abdul-basit-shaikh/CH32V003F4P6_tank_sensor/Tank_Sensor_Hardware_List.xlsx

Sheet: BOM_Components_List
CH32V003F4P6 TANK WATER LEVEL SENSOR — COMPLETE BOM & ROBU.IN BUYING LIST
S.No | Ref | Component Name | Value / Specification | Package / Footprint | Qty | Purpose & Function (Kis Liye Lagta Hai) | Robu.in Link | Buying / Engineering Notes
1 | U1 | Main Microcontroller (MCU) | CH32V003F4P6 (RISC-V 32-bit, 48MHz, 16KB Flash, 2KB SRAM) | TSSOP-20 | 1 | Poore tank sensor ka main brain. Probes read karta hai, deep sleep manage karta hai, battery calculate karta hai, aur LoRa se controller ko data bhejta hai. | 🔗 View on Robu.in (https://robu.in/?s=CH32V003&post_type=product) | Ultra-low power (~10µA sleep). WCH RISC-V core.
2 | U2 | Wireless LoRa Module | SX1278 Ra-02 (Ai-Thinker 433MHz) | SMD-16 Module | 1 | 433MHz Long Range Radio. Tanki se controller tak 500m - 1km+ range me water level aur battery data wirelessly transmit karta hai. | 🔗 View on Robu.in (https://robu.in/?s=SX1278+LoRa+Module+Ra-02&post_type=product) | SPI Interface, 433MHz frequency band.
3 | Q6 | P-Channel MOSFET | AO3401A / SI2301 (30V, 4.2A, Low Rds(on)) | SOT-23 | 1 | Anti-Corrosion High-Side Switch. Paani ke common wire me 24/7 current nahi bhejta. Jab MCU reading leta hai sirf 10ms ke liye VCC pulse deta hai, baki waqt paani me 0V rehta hai taaki probes rust/electrolysis se kharab na hon. | 🔗 View on Robu.in (https://robu.in/?s=AO3401A+MOSFET&post_type=product) | Gate connected to PD3 via 100k pull-up.
4 | Q1 | NPN Transistor (25% Probe) | BC547 / 2N3904 / MMBT3904 | TO-92 / SOT-23 | 1 | 25% Water Level Buffer. Paani 25% probe ko touch karta hai toh base trigger hokar Collector (PC0) ko LOW (0V) pull karta hai. | 🔗 View on Robu.in (https://robu.in/?s=BC547+Transistor&post_type=product) | Emitter to GND, Base via 100k resistor.
5 | Q2 | NPN Transistor (50% Probe) | BC547 / 2N3904 / MMBT3904 | TO-92 / SOT-23 | 1 | 50% Water Level Buffer. 50% level touch hone par Collector (PC1) ko LOW pull karta hai. | 🔗 View on Robu.in (https://robu.in/?s=BC547+Transistor&post_type=product) | Emitter to GND, Base via 100k resistor.
6 | Q3 | NPN Transistor (75% Probe) | BC547 / 2N3904 / MMBT3904 | TO-92 / SOT-23 | 1 | 75% Water Level Buffer. 75% level touch hone par Collector (PC2) ko LOW pull karta hai. | 🔗 View on Robu.in (https://robu.in/?s=BC547+Transistor&post_type=product) | Emitter to GND, Base via 100k resistor.
7 | Q4 | NPN Transistor (100% Probe) | BC547 / 2N3904 / MMBT3904 | TO-92 / SOT-23 | 1 | 100% Water Level Buffer. 100% level touch hone par Collector (PC4) ko LOW pull karta hai. | 🔗 View on Robu.in (https://robu.in/?s=BC547+Transistor&post_type=product) | Emitter to GND, Base via 100k resistor.
8 | Q5 | P-Channel MOSFET (Option B) | AO3401A / SI2301 | SOT-23 | 1 (Opt B) | Zero-Drop Reverse Battery Protection. 2x AA direct mode me battery ulti lagne par circuit ko instantly disconnect karta hai (Sirf 0.004V drop). | 🔗 View on Robu.in (https://robu.in/?s=AO3401A+MOSFET&post_type=product) | Gate to GND, Source to Bat+, Drain to Switch.
9 | U3 | 3.3V Low-Iq LDO (Option A) | HT7333-2 (Holtek) / XC6206P332MR | SOT-89 / SOT-23 | 1 (Opt A) | Voltage Regulator. 4x AA (6V) battery setup me voltage ko solid 3.3V pe regulate karta hai (Quiescent current < 3µA). | 🔗 View on Robu.in (https://robu.in/?s=HT7333&post_type=product) | High efficiency LDO for 5-7 years battery life.
10 | D2 | Step-down & Reverse Diode (Option A) | 1N4007 / M7 / 1N4002 | DO-41 / SMA | 1 (Opt A) | LDO Overvoltage Protection. 4x AA naye cells (6.4V) ko 0.7V drop karke 5.7V safe banata hai aur reverse polarity rokta hai. | 🔗 View on Robu.in (https://robu.in/?s=1N4007+Diode&post_type=product) | 1A general purpose rectifier.
11 | F1 | Resettable PTC Fuse | 500mA Resettable Fuse (Bourns / Littelfuse) | 1206 SMD | 1 | Short Circuit Protection. Agar battery terminals ya board me short circuit ho toh battery ko blast ya drain hone se bachata hai. | 🔗 View on Robu.in (https://robu.in/?s=1206+PTC+Fuse+500mA&post_type=product) | Auto-reset when short is cleared.
12 | C1 | Main Bulk Reservoir Capacitor | 100µF 16V / 25V (Electrolytic / Ceramic) | Radial / 1206 | 1 | Energy Reservoir. Battery ke paas lagta hai. Jab LoRa module TX ke waqt sudden 120mA current spike leta hai, ye voltage drop nahi hone deta. | 🔗 View on Robu.in (https://robu.in/?s=100uF+Capacitor&post_type=product) | Essential for battery longevity & radio stability.
13 | C2 | LoRa Bulk Capacitor | 10µF 10V/16V Ceramic | 0805 SMD | 1 | LoRa Local Power Buffer. LoRa VCC/GND ke 3mm paas lagta hai for local current supply. | 🔗 View on Robu.in (https://robu.in/?s=10uF+0805+SMD+Capacitor&post_type=product) | Low ESR Ceramic capacitor.
14 | C3 | LoRa RF Decoupling Capacitor | 100nF (104) 50V Ceramic | 0603 / 0805 SMD | 1 | High-Frequency Noise Filter. LoRa module ke digital switching aur SPI clock noise ko ground karta hai. | 🔗 View on Robu.in (https://robu.in/?s=100nF+0805+SMD+Capacitor&post_type=product) | Place right at LoRa VCC/GND pins.
15 | C4 | MCU Decoupling Capacitor | 100nF (104) 50V Ceramic | 0603 / 0805 SMD | 1 | MCU Power Filter. CH32V003 MCU ke VDD (Pin 9) aur VSS (Pin 7) ke bilkul paas lagta hai. | 🔗 View on Robu.in (https://robu.in/?s=100nF+0805+SMD+Capacitor&post_type=product) | Clean digital supply for MCU.
16 | C5 | MCU Reset Capacitor | 100nF (104) 50V Ceramic | 0603 / 0805 SMD | 1 | Clean Power-On Reset. NRST pin ko power-on par clean reset pulse deta hai aur false resets rokta hai. | 🔗 View on Robu.in (https://robu.in/?s=100nF+0805+SMD+Capacitor&post_type=product) | Connected from NRST to GND.
17 | C6-C9 | Probe Filter Capacitors | 4x 100nF (104) 50V Ceramic | 0603 / 0805 SMD | 4 | Noise / ESD Filter. Tanki ke 25%, 50%, 75%, 100% lambe taaron se aane wale static, RF noise aur false triggering ko ground karte hain. | 🔗 View on Robu.in (https://robu.in/?s=100nF+0805+SMD+Capacitor&post_type=product) | Connected across each probe input to GND.
18 | C10 | Common Line Filter Capacitor | 100nF (104) 50V Ceramic | 0603 / 0805 SMD | 1 | Common Line Protection. Common sensor line ko ESD aur static spike se bachata hai. | 🔗 View on Robu.in (https://robu.in/?s=100nF+0805+SMD+Capacitor&post_type=product) | Connected from Common to GND.
19 | R3 | NRST Pull-up Resistor | 10kΩ 5% (0.125W) | 0603 / 0805 SMD | 1 | Reset Pin Stabilizer. CH32V003 ke NRST (Pin 4) ko VCC se pull-up rakhta hai taaki chip hang na ho. | 🔗 View on Robu.in (https://robu.in/?s=10k+0805+SMD+Resistor&post_type=product) | NRST to VDD.
20 | R4 | LED Resistor | 1kΩ 5% (0.125W) | 0603 / 0805 SMD | 1 | LED Current Limiter. Status LED (PD2) ko safe 1-2mA current deta hai taaki battery waste na ho. | 🔗 View on Robu.in (https://robu.in/?s=1k+0805+SMD+Resistor&post_type=product) | PD2 to LED Anode.
21 | R5-R8 | Probe Base Resistors | 4x 100kΩ 5% (0.125W) | 0603 / 0805 SMD | 4 | Transistor Base Current Limiter. Q1-Q4 BC547 ke base me safe micro-ampere current allow karte hain jab paani touch hota hai. | 🔗 View on Robu.in (https://robu.in/?s=100k+0805+SMD+Resistor&post_type=product) | Probe lines to Base pins.
22 | R9 | MOSFET Gate Pull-up Resistor | 100kΩ 5% (0.125W) | 0603 / 0805 SMD | 1 | Q6 Gate Lock. PD3 floating hone par ya deep sleep ke waqt Q6 Gate ko VCC se pull karke MOSFET ko 100% OFF rakhta hai. | 🔗 View on Robu.in (https://robu.in/?s=100k+0805+SMD+Resistor&post_type=product) | Q6 Gate to VCC.
23 | D1 | Status Indicator LED | 3mm Green LED / 0805 SMD | SMD / TH | 1 | User Feedback. Pairing mode, reset indication, aur data transmission confirmation blink karne ke liye. | 🔗 View on Robu.in (https://robu.in/?s=Green+LED+0805&post_type=product) | Active HIGH from PD2.
24 | SW1 | User Push Button | 6x6mm Tactile Switch | SMD / TH | 1 | Pairing & Reset. 3s hold = Reboot, 5s hold = Controller ke saath Pairing Mode. | 🔗 View on Robu.in (https://robu.in/?s=Tactile+Push+Button+6x6&post_type=product) | Active LOW connected to PD6.
25 | SW2 | Power Slide Switch | SPST Slide Switch 3-Pin | Through-Hole | 1 | Battery ON/OFF Switch. Board ko storage ya maintenance ke waqt physically switch off karne ke liye. | 🔗 View on Robu.in (https://robu.in/?s=SPST+Slide+Switch&post_type=product) | In series with battery positive line.
26 | J1 | Battery Connector | 2-Pin JST-XH / 2.54mm Screw Terminal | Through-Hole | 1 | Battery pack (2x AA ya 4x AA holder) connect karne ke liye. | 🔗 View on Robu.in (https://robu.in/?s=JST+XH+2+Pin+Connector&post_type=product) | Polarized connector recommended.
27 | J2 | SWD Programming Header | 1x3 Male Header (2.54mm) | Through-Hole | 1 | Firmware Flashing. WCH-LinkE programmer se code upload karne ke liye (VCC, SWIO/PD1, GND). | 🔗 View on Robu.in (https://robu.in/?s=2.54mm+Male+Berg+Strip&post_type=product) | Single-wire debug header.
28 | J3 | Tank Sensor Connector | 1x5 Screw Terminal Block (3.81mm / 5.08mm) | Through-Hole | 1 | Tanki ke 5 taar connect karne ke liye: Common (VCC), 25%, 50%, 75%, 100%. | 🔗 View on Robu.in (https://robu.in/?s=5+Pin+Screw+Terminal+Block&post_type=product) | Heavy duty screw terminal.
29 | J4 | Debug UART Header | 1x2 Male Header (2.54mm) | Through-Hole | 1 | Serial monitor debugging ke liye (PD5 TX + GND). | 🔗 View on Robu.in (https://robu.in/?s=2.54mm+Male+Berg+Strip&post_type=product) | Optional for debugging.
30 | ANT1 | 433MHz LoRa Antenna | Spring Coil Antenna / IPEX SMA Whip | 433 MHz | 1 | LoRa signal transmit karne ke liye. | 🔗 View on Robu.in (https://robu.in/?s=433MHz+Spring+Antenna&post_type=product) | Solder directly or use IPEX connector.
31 | PROBES | Water Level Probes | SS304 / SS316 Stainless Steel Screws / Rods | M3 / M4 Bolt | 5 | Paani ke andar daalne ke liye rust-proof probes. | 🔗 View on Robu.in (https://robu.in/?s=Stainless+Steel+Bolt+M3&post_type=product) | Stainless steel (Do not use bare copper).
32 | PROG1 | WCH Programmer (Tool) | WCH-LinkE Programmer / Debugger | USB Tool | 1 | CH32V003 MCU me code flash aur debug karne ke liye official hardware programmer. | 🔗 View on Robu.in (https://robu.in/?s=WCH-LinkE+Programmer&post_type=product) | Connects to J2 header (SWIO, VCC, GND).

Sheet: MCU_Pin_Mapping
CH32V003F4P6 TSSOP-20 COMPLETE PIN MAPPING
TSSOP-20 Pin | Pin Name | Connected Component / Signal | Direction / Mode | Description & Circuit Function
Pin 1 | PD4 | SX1278 LoRa RST | Output | LoRa Module Hardware Reset Line
Pin 2 | PD5 | J4 Debug UART TX | Output | 115200 Baud Serial Debug Print (Optional)
Pin 3 | PD6 | SW1 Push Button | Input (Pull-Up) | Pairing / Reset / Reboot Button (Active LOW, EXTI Wakeup)
Pin 4 | PD7 | NRST (R3 10k + C5 104) | Input / Reset | MCU Hardware Reset with RC Noise Filter
Pin 5 | PA1 | NC (Internal Vref used) | Analog Input | Battery monitored via 1.20V Internal Bandgap (0µA drain)
Pin 6 | PA2 | NC | Spare GPIO | Unconnected / Spare Test Pad
Pin 7 | VSS | Ground Plane (GND) | Power | Main System Ground
Pin 8 | PD0 | NC | Spare GPIO | Unconnected / Spare Test Pad
Pin 9 | VDD | VCC Rail (3.0V - 3.3V) + C4 (104) | Power | Main MCU Power Input (with 100nF Decoupling Cap)
Pin 10 | PC0 | Q1 Collector (25% Probe) | Input (Pull-Up) | 25% Water Level Detector (Reads LOW when water reaches 25%)
Pin 11 | PC1 | Q2 Collector (50% Probe) | Input (Pull-Up) | 50% Water Level Detector (Reads LOW when water reaches 50%)
Pin 12 | PC2 | Q3 Collector (75% Probe) | Input (Pull-Up) | 75% Water Level Detector (Reads LOW when water reaches 75%)
Pin 13 | PC3 | SX1278 LoRa NSS (CS) | Output | SPI Chip Select for SX1278 LoRa Module
Pin 14 | PC4 | Q4 Collector (100% Probe) | Input (Pull-Up) | 100% Water Level Detector (Reads LOW when water reaches 100%)
Pin 15 | PC5 | SX1278 LoRa SCK | AF Output | SPI1 Clock Line for LoRa Communication
Pin 16 | PC6 | SX1278 LoRa MOSI | AF Output | SPI1 Master-Out-Slave-In Data Line
Pin 17 | PC7 | SX1278 LoRa MISO | Input (Pull-Up) | SPI1 Master-In-Slave-Out Data Line
Pin 18 | PD1 | J2 SWIO Header | Bidirectional | Single-Wire Debug / Flash Programming Interface
Pin 19 | PD2 | D1 Status LED (via R4 1k) | Output | Status Indicator LED (Active HIGH: Blinks for TX, Pairing)
Pin 20 | PD3 | Q6 P-MOSFET Gate (via R9 100k) | Output | Common Probe Driver (Active LOW: Pulsed 3V for 10ms)
