abdul-basit-shaikh/CH32V003F4P6_tank_sensor/(list of files, drawings)

Other design files:
PCB/temp-freerouting.dsn
