abdul-basit-shaikh/CH32V003F4P6_tank_sensor/PCB/Tank_Sensor.kicad_pcb

## KiCad design PCB/Tank_Sensor.kicad_pcb (2026-08-27)

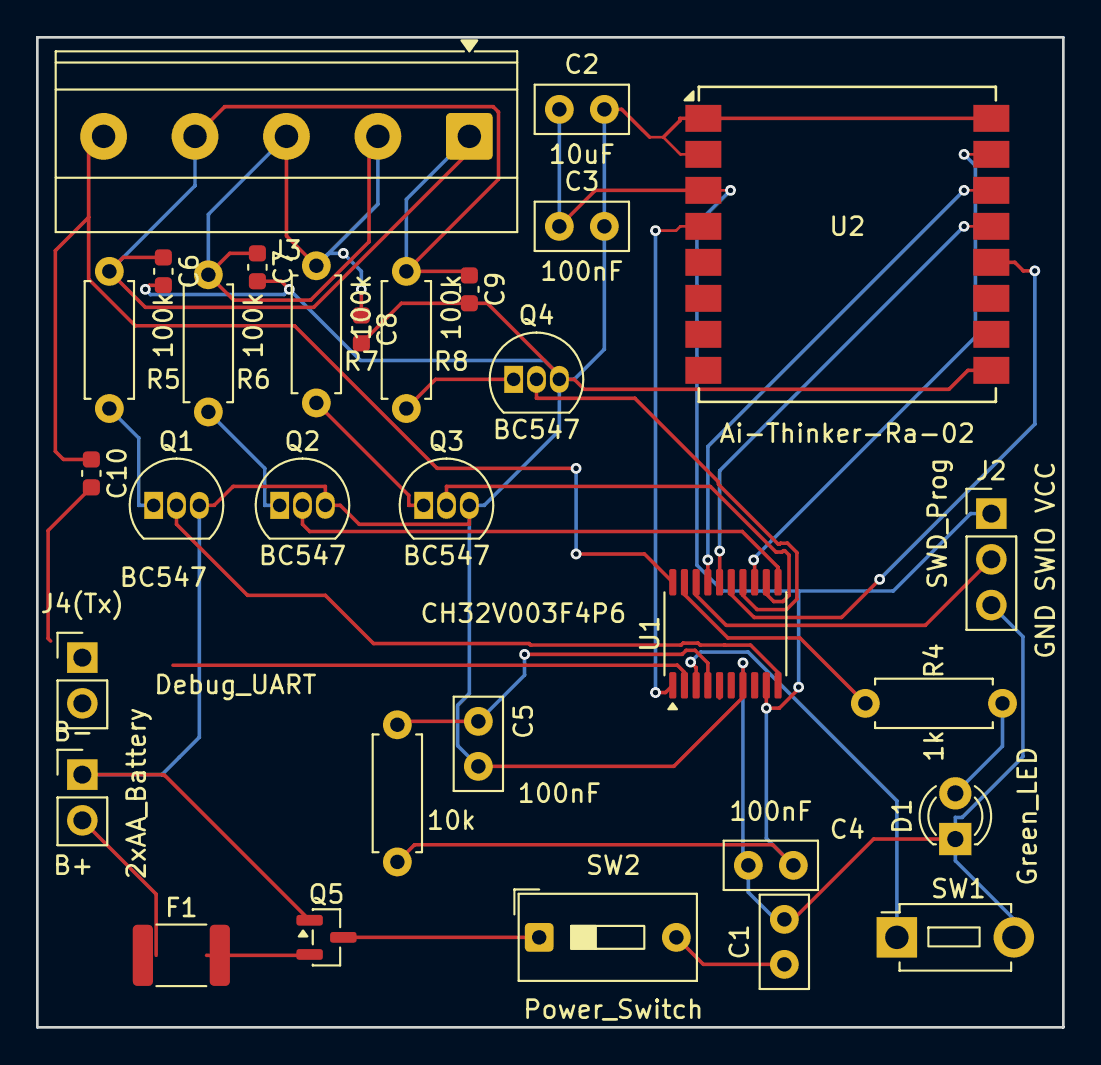
[picture p1: board Tank_Sensor.kicad_pcb from above]

Board: 2 copper layers, 57.0 x 55.0 mm, 31 parts (0 on the bottom side), 27 nets.

Parts:
B-: 2xAA_Battery; PinHeader_1x02_P2.54mm_Vertical
C1: 100uF; C_Disc_D5.0mm_W2.5mm_P2.50mm
C2: 10uF; C_Disc_D5.0mm_W2.5mm_P2.50mm
C3, C4, C5: 100nF; C_Disc_D5.0mm_W2.5mm_P2.50mm
C6, C7, C8, C9, C10: 100nF; C_0603_1608Metric
D1: Green_LED; LED_D3.0mm
F1: 500mA_PTC; Fuse_1812_4532Metric
J2: SWD_Prog; PinHeader_1x03_P2.54mm_Vertical
J3: Sensor_Conn; TerminalBlock_Phoenix_MKDS-1,5-5-5.08_1x05_P5.08mm_Horizont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
J4(Tx): Debug_UART; PinHeader_1x02_P2.54mm_Vertical
Q1, Q2, Q3, Q4: BC547; TO-92_Inline
Q5: AO3401A; SOT-23
R3: 10k; R_Axial_DIN0207_L6.3mm_D2.5mm_P7.62mm_Horizontal
R4: 1k; R_Axial_DIN0207_L6.3mm_D2.5mm_P7.62mm_Horizontal
R5, R6, R7, R8: 100k; R_Axial_DIN0207_L6.3mm_D2.5mm_P7.62mm_Horizontal
SW1: BTN_6mm; SW_PUSH_1P1T_6x3.5mm_H5.0_APEM_MJTP1250
SW2: Power_Switch; SW_DIP_SPSTx01_Slide_9.78x4.72mm_W7.62mm_P2.54mm
U1: CH32V003F4P6; TSSOP-20_4.4x6.5mm_P0.65mm
U2: Ai-Thinker-Ra-02; Ai-Thinker-Ra-01-LoRa

Connections:
/BTN: SW1.1, U1.3 (PD6)
/LED_A: D1.2 (A), R4.2
/LED_DRIVE: R4.1, U1.19 (PD2)
/LORA_NSS: U1.13 (PC3/NSS), U2.15 (~NSS)
/LORA_RST: U1.1 (PD4), U2.4 (~RESET)
/NRST: C5.1, R3.2, U1.4 (~NRST/PD7)
/PROBE_25: C6.1, J3.1, R5.1
/PROBE_50: C7.1, J3.2, R6.1
/PROBE_75: C8.1, J3.3, R7.1
/PROBE_100: C9.1, J3.4, R8.1
/Q1_B: Q1.1 (B), R5.2
/Q2_B: Q2.1 (B), R6.2
/Q3_B: Q3.1 (B), R7.2
/Q4_B: Q4.1 (B), R8.2
/SENSOR_25: Q1.2 (C), U1.10 (PC0)
/SENSOR_50: Q2.2 (C), U1.11 (PC1)
/SENSOR_75: Q3.2 (C), U1.12 (PC2)
/SENSOR_100: Q4.2 (C), U1.14 (PC4)
/SPI_MISO: U1.17 (PC7/MISO), U2.14 (MOSI)
/SPI_MOSI: U1.16 (PC6/MOSI), U2.13 (MISO)
/SPI_SCK: U1.15 (PC5/SCK), U2.12 (SCK)
/SWIO: J2.2, U1.18 (PD1/SWIO)
/UART_TX: J4(Tx).1, U1.2 (PD5/UTX)
GND: B-.1, C1.2, C2.2, C3.2, C4.2, C5.2, C6.2, C7.2, C8.2, C9.2, C10.2, D1.1 (K), J2.3, J4(Tx).2, Q1.3 (E), Q2.3 (E), Q3.3 (E), Q4.3 (E), Q5.1 (G), SW1.2, U1.7 (VSS), U2.1 (GND), U2.2 (GND), U2.9 (GND), U2.16 (GND)
unnamed: Q5.3 (D), SW2.1
unnamed: F1.2, Q5.2 (S)
VCC: C1.1, C2.1, C3.1, C4.1, J2.1, R3.1, SW2.2, U1.9 (VDD), U1.20 (PD3), U2.3 (VDD)
