abdul-basit-shaikh/CH32V003F4P6_tank_sensor/(commit log)

2026-01-26 tank level ky liye pin or button or led ky pin set kr diya hai or data abhi ja raha hai or recveed bhi ho raha hai water level controller pr sahi se
2026-02-07 jab reset button pressed kary gy to tank id change hogi
2026-02-21 sanser first time add ho raha tha sirf os ko fixed kiya hai abhi kitne bar bhi add karo to jo ta hai
    [main.c, nrf24_simple.c]
2026-02-21 add battery pin ad feature and flash memory(save tak id ,other)
2026-02-24 jab water level chagne hoti hai or har 4hr mai device details send kary ga is se battery consumtion kam ho ga
2026-02-24 power down or deep sleep feature added but need to more improvement on it
2026-02-28 Enable Hardware CRC, optimize RF power, and improve sensor stability logic
    [config.h, main.c, nrf24_simple.c]
2026-02-28 singal click pr restart longpressed pr factory reset
    [main.c]
2026-03-01 Probe Fault Detected!
2026-03-07 Jo probe dtect nahi ho gi os ki information send ho gi
2026-04-19 battery ki range 2.7 to 3.3v kiya hai
2026-04-19 memory optiimized kary hai is mai or FLOATING to IPU (pin MISO PC7)
2026-08-17 SX1278 LoRa Module Ra- 02 433MHZ Wireless and Auto Wake-up (AWU) Timer logic change
    [Tank_Sensor.kicad_pcb, Tank_Sensor.kicad_sch, temp-freerouting.dsn]
2026-08-17 update in detection logic
    [Tank_Sensor.kicad_pcb]
2026-08-17 Water Level Accuracy & Anti-Slosh (Water Waves/Ripples) Filter
2026-08-17 Battery Monitoring mein improvement (Non-Linear Alkaline Curve (True %),IIR Filter (Temperature Swing Protection):)
2026-08-18 Commercial Low-Power Optimizations and button logic change
2026-08-27 update led or mosfet logic or level detect logic
    [Tank_Sensor.kicad_pcb, Tank_Sensor.kicad_sch, untitled.kicad_sch]
2026-08-27 ultra-battery efficient
2026-08-27 Hardware Components & BOM List
    [Tank_Sensor.kicad_pcb, Tank_Sensor.kicad_sch, Tank_Sensor_Hardware_List.xlsx]
2026-09-04 Hardware CRC Error Flag Check, Weak Random ID Generation at Boot, Sensor ACK & Pairing Checksum Verification, IWDG Watchdog Comment & Log Mismatch
    [lora_sx1278.c, main.c]
2026-09-05 fix: complete final fitting at home
    [main.c]
